kychloe567/16BitComputer/Output_images/complete_bw.png

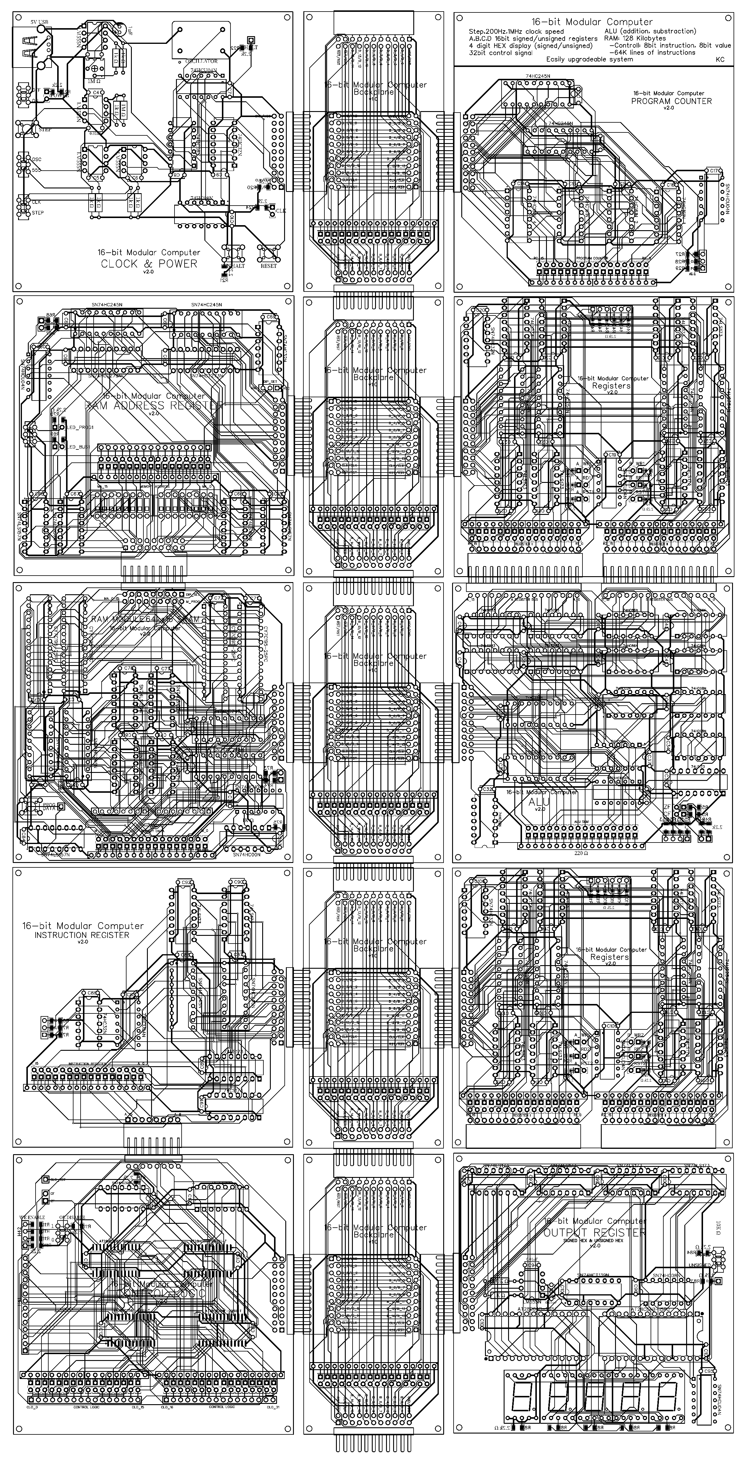
Output_images/complete_bw.png
