kychloe567/16BitComputer/BOMs/digikey/BOM_PCB_16BIT_BUS_2023-01-31.csv

Name | Quantity
Male header 2x11 | 1
LED | 16
Resistor array | 2
Female header 2x11 | 3
