kychloe567/16BitComputer/BOMs/digikey/BOM_PCB_16BIT_CLOCK_2023-01-31.csv

Name | Quantity
Button | 3
1kΩ | 8
5kΩ | 1
SN74HCU04N | 1
1uF | 1
0.01uF | 2
0.1uF | 7
Male header 2x11 | 1
Male header 1x1 | 1
1MΩ | 1
220Ω | 2
JS202011CQN | 3
LM555N | 4
USB | 1
LED | 2
1MHz | 1
AND_SN74HC08N | 2
OR_SN74HC32N | 1
1MΩ Adj | 1
