kychloe567/16BitComputer/BOMs/digikey/BOM_PCB_16BIT_REGISTER_2023-01-31.csv

Name | Quantity
Female header 1x16 | 2
INV_SN74HCU04N | 1
OR_SN74HC32N | 1
Male header 2x11 | 1
LED | 38
Resistor array | 4
SN74LS173 | 8
220Ω | 6
0.1uF | 14
Male header 1x6 | 1
SN74HC245N | 4
