kychloe567/16BitComputer/BOMs/digikey/BOM_PCB_16BIT_OUTPUT_SEVENSEGMENT_2023-01-31.csv

Name | Quantity
0.1uF | 9
0.01uF | 2
Male header 2x11 | 1
Male header 1x1 | 1
7Segment | 5
320Ω | 5
10KΩ | 1
1KΩ | 1
100KΩ | 1
JS202011CQN | 1
AT28C64B-15PU | 2
SN74HCT139N | 1
74LS173 | 4
AND_SN74HC08N | 1
INV_SN74HCU04N | 1
LM555N | 1
