kychloe567/16BitComputer/(list of files, drawings)

Other design files:
Logisim/16BitCPU.circ
LogisimExact/16BitCPU.circ
