kychloe567/16BitComputer/(commit log)

2024-01-10 Logisim simulation
    [16BitCPU.circ]
2024-01-11 Control logic not working
    [16BitCPU.circ]
2024-01-11 16bit works, conditional jump i dont know
    [16BitCPU.circ]
2024-01-16 Exact cpu updated, not finished yet
    [16BitCPU.circ]
2024-01-17 7segment program update
    [16BitCPU.circ]
2024-01-19 7SEGMENT working
    [16BitCPU.circ]
